cvra/uwb-beacon-board/README.md

# Universal beacon system board

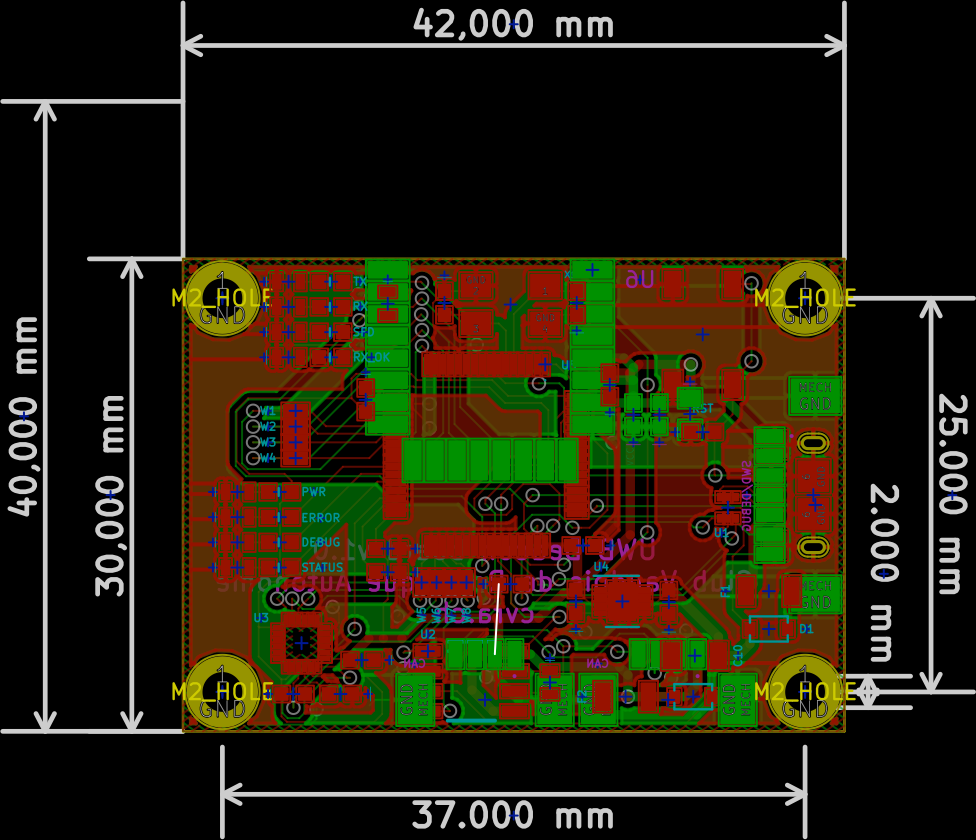
[picture p1: board_outline.png]
Board outline


This repository holds the schematics and layout of a board used as beacon localisation system for Eurobot.
It uses an Ultra-Wide Band module from Decawave and IMU.
