cvra/uwb-beacon-board/beacon.pdf

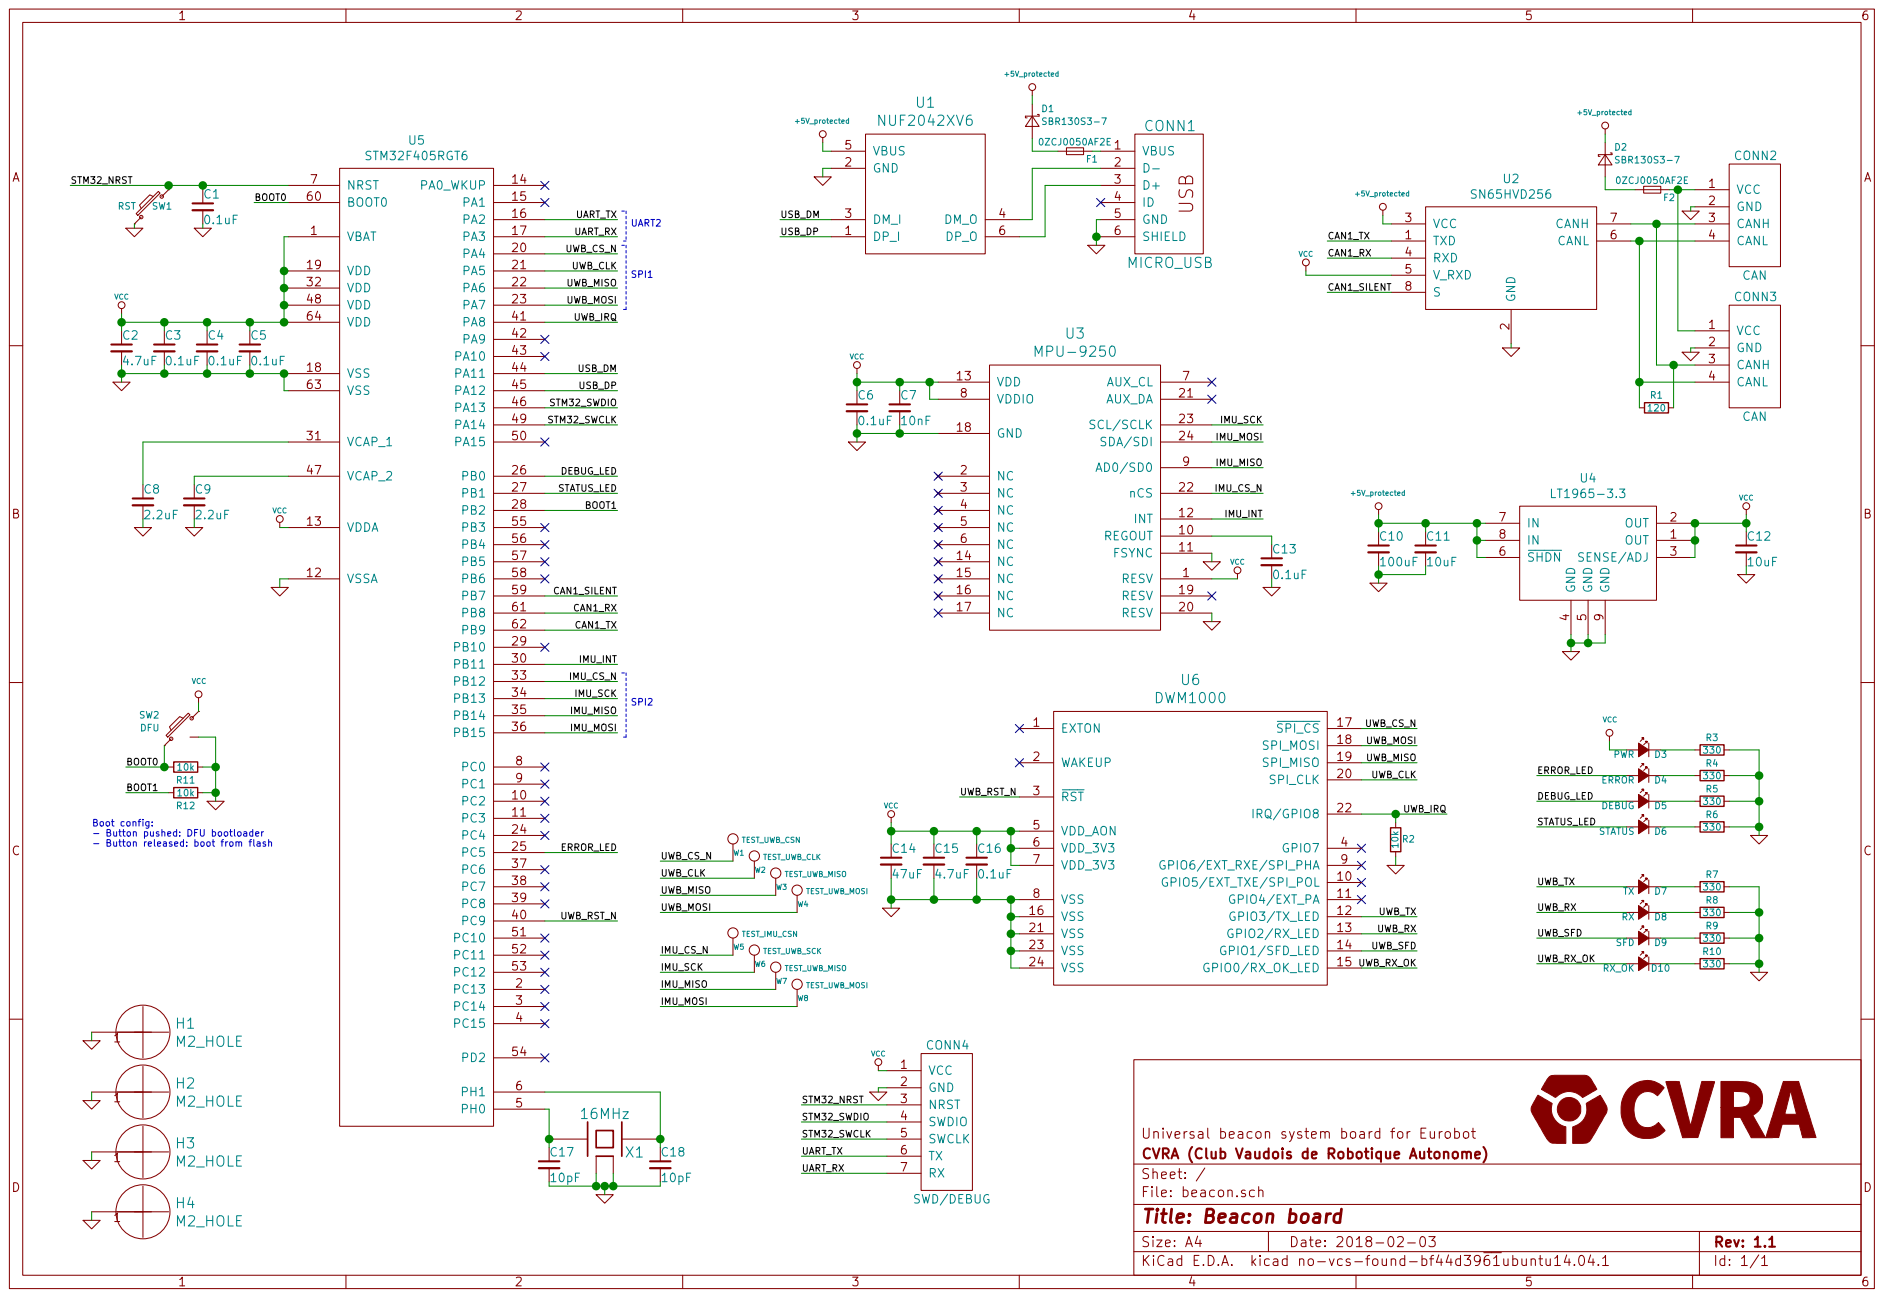
[picture p2: page 1]

2 VCC 3 RXD 4 V_RXD 5 CANL 6 CANH 7 S

VCC Boot config: - Button pushed: DFU bootloader

- Button released: boot from flash

Universal beacon system board for Eurobot
File: beacon.sch Sheet: / CVRA (Club Vaudois de Robotique Autonome)

Id: 1/1 Title: Beacon board
