cvra/uwb-beacon-board/beacon.kicad_pcb

## KiCad design beacon.kicad_pcb (2018-02-20)

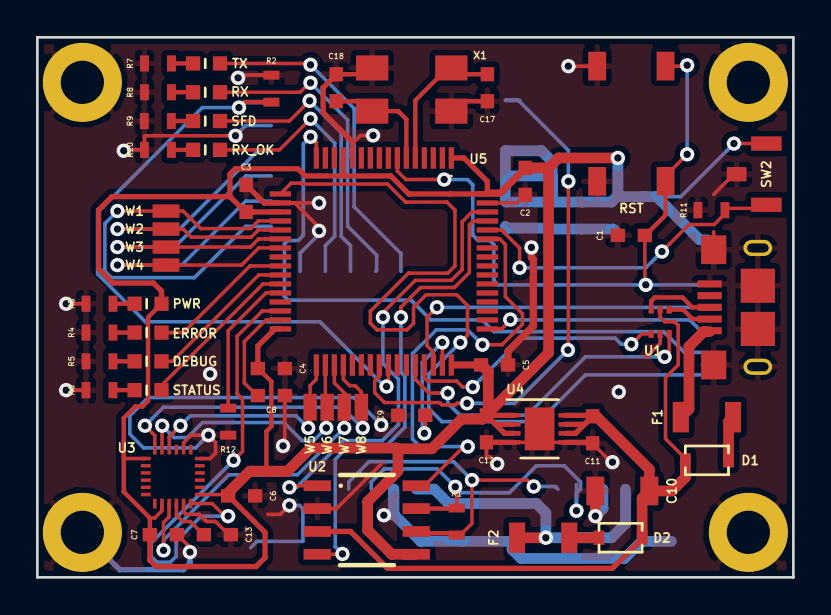
[picture p3: board beacon.kicad_pcb from above]

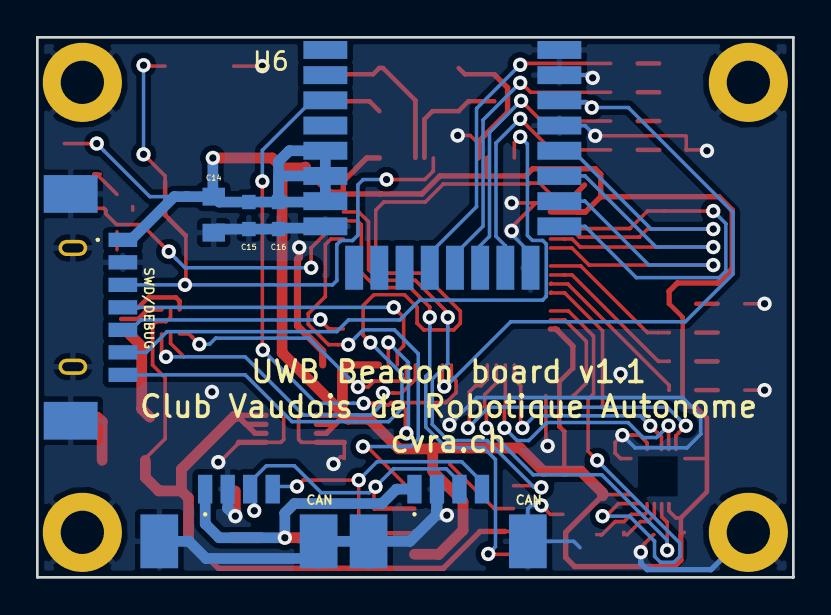
[picture p4: board beacon.kicad_pcb from below]

Board: 2 copper layers, 42.0 x 30.0 mm, 67 parts (7 on the bottom side), 54 nets.

Parts:
C1, C3, C4, C5, C6, C13, C16: 0.1uF; C_0603
C2, C15: 4.7uF; C_0603
C7: 10nF; C_0603
C8, C9: 2.2uF; C_0603
C10: 100uF; C_1206
C11, C12: 10uF; C_0603
C14: 47uF; C_0805
C17, C18: 10pF; C_0603
CONN1: MICRO_USB; _Micro-USB-AB-receptacle-SMT-th
CONN2, CONN3: CAN; _Molex-PicoBlade-SMD-4
CONN4: SWD/DEBUG; _Molex-PicoBlade-SMD-7
D1, D2: SBR130S3-7; _SOD-323
D3: PWR; D_0603
D4: ERROR; D_0603
D5: DEBUG; D_0603
D6: STATUS; D_0603
D7: TX; D_0603
D8: RX; D_0603
D9: SFD; D_0603
D10: RX_OK; D_0603
F1, F2: 0ZCJ0050AF2E; R_1206
H1, H2, H3, H4: M2_HOLE; _M2
R1: 120; R_0603
R2, R11, R12: 10k; R_0603
R3, R4, R5, R6, R7, R8, R9, R10: 330; R_0603
SW1: RST; _PTS525SK15-SMT-Pushbutton
SW2: DFU; SMD_Pushbutton_B3U-3100P
U1: NUF2042XV6; SOT-563_6-lead
U2: SN65HVD256; _SO-8
U3: MPU-9250; _MPU-9XX0
U4: LT1965-3.3; DFN-8-1EP_3x3mm_Pitch0.5mm
U5: STM32F405RGT6; _LQFP64
U6: DWM1000
W1: TEST_UWB_CSN; Test_1pin_SMD
W2: TEST_UWB_CLK; Test_1pin_SMD
W3, W7: TEST_UWB_MISO; Test_1pin_SMD
W4, W8: TEST_UWB_MOSI; Test_1pin_SMD
W5: TEST_IMU_CSN; Test_1pin_SMD
W6: TEST_UWB_SCK; Test_1pin_SMD
X1: 16MHz; XTAL_ABMM2

Connections:
+5V_protected: C10.1, C11.1, D1.1, D2.1, U1.5, U2.3, U4.6, U4.7, U4.8
/BOOT0: R11.2, SW2.1, U5.60
/BOOT1: R12.2, U5.28
/CAN1_RX: U2.4, U5.61
/CAN1_SILENT: U2.8, U5.59
/CAN1_TX: U2.1, U5.62
/DEBUG_LED: D5.2, U5.26
/ERROR_LED: D4.2, U5.25
/IMU_CS_N: U3.22, U5.33, W5.1
/IMU_INT: U3.12, U5.30
/IMU_MISO: U3.9, U5.35, W7.1
/IMU_MOSI: U3.24, U5.36, W8.1
/IMU_SCK: U3.23, U5.34, W6.1
/STATUS_LED: D6.2, U5.27
/STM32_NRST: C1.1, CONN4.3, SW1.2, U5.7
/STM32_SWCLK: CONN4.5, U5.49
/STM32_SWDIO: CONN4.4, U5.46
/UART_RX: CONN4.7, U5.17
/UART_TX: CONN4.6, U5.16
/USB_DM: U1.3, U5.44
/USB_DP: U1.1, U5.45
/UWB_CLK: U5.21, U6.20, W2.1
/UWB_CS_N: U5.20, U6.17, W1.1
/UWB_IRQ: R2.2, U5.41, U6.22
/UWB_MISO: U5.22, U6.19, W3.1
/UWB_MOSI: U5.23, U6.18, W4.1
/UWB_RST_N: U5.40, U6.3
/UWB_RX: D8.2, U6.13
/UWB_RX_OK: D10.2, U6.15
/UWB_SFD: D9.2, U6.14
/UWB_TX: D7.2, U6.12
GND: C1.2, C2.2, C3.2, C4.2, C5.2, C6.2, C7.2, C8.2, C9.2, C10.2, C11.2, C12.2, C13.2, C14.2, C15.2, C16.2, C17.2, C18.2, CONN1.5, CONN1.6, CONN2.2, CONN2.MECH, CONN3.2, CONN3.MECH, CONN4.2, CONN4.MECH, H1.1, H2.1, H3.1, H4.1, R2.1, R3.1, R4.1, R5.1, R6.1, R7.1, R8.1, R9.1, R10.1, R11.1, R12.1, SW1.1, SW2.3, U1.2, U2.2, U3.11, U3.18, U3.20, U4.4, U4.5, U4.9, U5.12, U5.18, U5.63, U6.8, U6.16, U6.21, U6.23, U6.24, X1.2, X1.4
unnamed: C8.1, U5.31
unnamed: C9.1, U5.47
unnamed: C13.1, U3.10
unnamed: C17.1, U5.5, X1.1
unnamed: C18.1, U5.6, X1.3
unnamed: CONN1.1, F1.1
unnamed: CONN1.2, U1.4
unnamed: CONN1.3, U1.6
unnamed: CONN2.1, CONN3.1, F2.1
unnamed: CONN2.3, CONN3.3, R1.1, U2.7
unnamed: CONN2.4, CONN3.4, R1.2, U2.6
unnamed: D1.2, F1.2
unnamed: D2.2, F2.2
unnamed: D3.1, R3.2
unnamed: D4.1, R4.2
unnamed: D5.1, R5.2
unnamed: D6.1, R6.2
unnamed: D7.1, R7.2
unnamed: D8.1, R8.2
unnamed: D9.1, R9.2
unnamed: D10.1, R10.2
VCC: C2.1, C3.1, C4.1, C5.1, C6.1, C7.1, C12.1, C14.1, C15.1, C16.1, CONN4.1, D3.2, SW2.2, U2.5, U3.1, U3.8, U3.13, U4.1, U4.2, U4.3, U5.1, U5.13, U5.19, U5.32, U5.48, U5.64, U6.5, U6.6, U6.7
