cvra/uwb-beacon-board/(threads)

Thread 1 (2017-08-10):

No way to enter DFU

antoinealb, 2017-08-10:
It would be nice to be able to program the board using only the USB connection, through built in DFU bootloader. Adding a small switch or button for this would be nice.

SyrianSpock, 2017-08-10:
The current revision has BOOT0 wired to ground, so the board can't be modified easily.

romaincvra, 2017-08-10:
Just use the CAN bootloader... Colinet

antoinealb, 2017-08-10:
> The current revision has BOOT0 wired to ground, so the board can't be modified easily.

I know.  Just something to keep in mind for revB.

> Just use the CAN bootloader... Colinet

Precisely, I need the DFU bootloader to install the CAN bootloader 😉

antoinealb, 2017-10-12:
This will require rewiring of the STATUS_LED signal, as it is currently connected to boot1.

Closed 2018-02-20.

Thread 2 (2017-10-04):

UWB module reset pin is driven by USB peripheral

antoinealb, 2017-10-04:
Out of the usual engineering bad luck, we assigned the UWB's reset pin to a pin used by the USB FS PHY module (see enclosed picture). This means the module was always held into reset (RSTn was at ~1V) and never answered over SPI. 😢 When I disabled USB completely (using UART for shell), I was able to get it working right away.

Of course there might be a way to fix this in software, but since we have a lot of unused pins on the microcontroller, we might as well re-route it to a different pin not affected by this issue.

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

SyrianSpock, 2017-10-04:
Well, that's unfortunate. We can fix that in the next version. So it's not possible to use USB at all ? Otherwise I can rework the PCBs to reroute the trace that causes problems.

antoinealb, 2017-10-04:
I could not make USB and UWB module work at the same time. For now I worked around it by disabling USB and using UART. I can discuss it with my supervisor tomorrow to see if he has an idea, otherwise we can probably cut the trace and solder a wire to another pin.

SyrianSpock, 2017-10-04:
That's what I was suggesting, but can't you disable the VBUS function while still using USB ? I know that you can tell ChibiOS to ignore VBUS, but I don't know how to avoid overriding the alternate function.

antoinealb, 2017-10-04:
So ChibiOS clearly doesn't support removing the alternate function of the pin, and I am not sure if its even possible given the USB PHY.

VBUS is already ignored by the way, since it is not connected.

SyrianSpock, 2017-10-04:
Fair enough.

"Marcel, fait chauffer le fer !"

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

antoinealb, 2017-10-05:
So after discussion, the best would be to wire PA9 to actual VBus, because on some hosts it does not work properly without it and use another pin for UWB_RST

antoinealb, 2017-10-12:
Tested it tonight: reworked a board to remove connection between UWB_RST and PA9,  and USB works at the same time as UWB. yay.

Closed 2018-02-20.

Thread 3 (2017-11-14):

Debug and status LEDs are the same color

antoinealb, 2017-11-14:
On my batch of boards, both Debug and status are red LEDs. I think replacing debug in another color (orange ?) could ease identification of what is happening.

SyrianSpock, 2017-11-14:
They were meant to be different colors, I must have messed up my order or the assembly.

Closed 2018-02-20.

Thread 4 (2017-12-01):

Use through hole USB connectors

antoinealb, 2017-12-01:
Otherwise it might be fragile (haven't broken anything yet though).

SyrianSpock, 2018-01-13:
Do you think this is still needed? Switching to throughole would change the layout significantly since there is the Debug connector on the other side of USB.

antoinealb, 2018-01-13:
Nope, haven't killed the boards yet. Might be sturdier than I thought.

Closed 2018-01-13.

Thread 7 (2019-09-05):

Reliability issues

antoinealb, 2019-09-05:
At the 2019 cup, we observed that the board sometimes stopped working without reasons, but only inside the robot. Back in the days we thought it was due to ESD, but then we noticed the boards starter working again when powered by USB, or left aside for a long time. Replaced boards would also die very soon.

Since thermal could be a possibility, I borrowed a thermal camera and did some measurements on my bench. Here are the results, showing the hotspots being the microcontroller and the 3.3V power supply.

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
