cvra/uwb-beacon-board/(commit log)

2016-06-22 Setup KiCad project with libraries
    [beacon.kicad_pcb, beacon.sch]
2016-06-22 Add MCU, oscillator and debug connector
    [beacon.sch]
2016-06-23 Add Decawave 1000 module
    [beacon.sch]
2016-06-23 Add USB
    [beacon.sch]
2016-06-23 Add IMU
    [beacon.sch]
2016-06-23 Add CAN interface
    [beacon.sch]
2016-06-23 Add power regulator for VCC 3.3V
    [beacon.sch]
2016-06-23 Choose an appropriate PTC resettable fuse
    [beacon.sch]
2016-06-23 Add debug leds, logo & plot pdf
    [beacon.sch]
2016-06-23 Annotate schematic
    Also added missing capacitors on MCU
    [beacon.sch]
2016-06-24 Update with first corrections from review
    Add reset button
    Fix CAN wiring
    Add test pads on SPI buses
    Fix MCU pin name
    [beacon.sch]
2016-06-26 Update with further corrections from review
    LED resistors 330 so we sink ~3mA at 3.3V
    Fix NUF2042XV6 name
    Fix MPU9205 wiring (contradictory datasheet)
    [beacon.sch]
2016-06-28 Place components, first try
    [beacon.kicad_pcb, beacon.sch]
2016-06-28 Update component placement
    [beacon.kicad_pcb]
2016-06-28 Add mounting holes and fix testpads
    [beacon.kicad_pcb, beacon.sch]
2016-06-28 Add logo
    [beacon.kicad_pcb]
2016-06-29 Route PCB
    [beacon.kicad_pcb]
2016-07-04 Generate gerber files
    [beacon-B.Cu.gbl, beacon-B.Mask.gbs, beacon-B.Paste.gbp, beacon-B.SilkS.gbo, beacon-Edge.Cuts.gm1, beacon-F.Cu.gtl, beacon-F.Mask.gts, beacon-F.Paste.gtp]
2016-07-13 Correct PCB routing from review remarks
    - MPU9250 footprint
    - Missing vias for good ground
    [beacon-B.Cu.gbl, beacon-B.Mask.gbs, beacon-B.Paste.gbp, beacon-B.SilkS.gbo, beacon-Edge.Cuts.gm1, beacon-F.Cu.gtl, beacon-F.Mask.gts, beacon-F.Paste.gtp]
2016-07-20 Corrections from review remarks
    [beacon.kicad_pcb, beacon.sch]
2017-12-21 Add board dimensions to README
2018-01-13 Rewire UWB reset to not interfere with VUSB sense
    Fixes #2
    [beacon.kicad_pcb, beacon.sch]
2018-02-03 Make it possible to boot from DFU
    Fixes #1
    [beacon.sch]
2018-02-03 Move status LED pins
    [beacon.sch]
2018-02-03 Move UWB reset from USB ID to PC9
    [beacon.sch]
2018-02-04 Update netlist/layout
    [beacon.kicad_pcb]
2018-02-04 Generate pdf of schematics
    [beacon.sch]
2018-02-20 Minor changes to gerber before prod
    [beacon-B.Cu.gbl, beacon-B.Mask.gbs, beacon-B.Paste.gbp, beacon-B.SilkS.gbo, beacon-Edge.Cuts.gm1, beacon-F.Cu.gtl, beacon-F.Mask.gts, beacon-F.Paste.gtp]
